Maciekskc/Lock-Arduino-project/zdjęcia do dokumentacji/lock-machanism.jpg

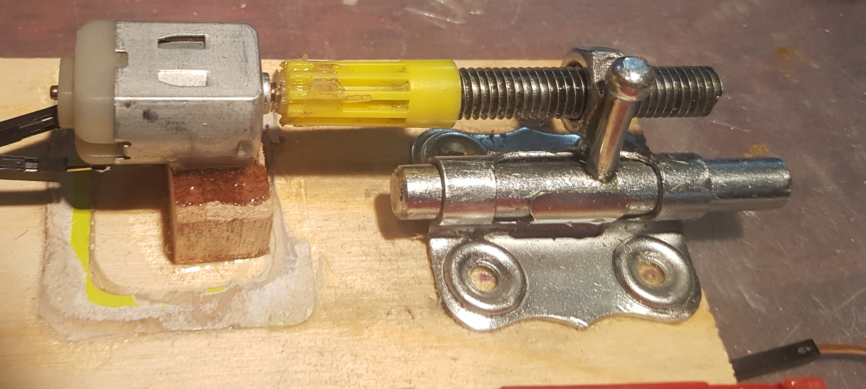
zdjęcia do dokumentacji/lock-machanism.jpg
