Maciekskc/Lock-Arduino-project/zdjęcia do dokumentacji/voltomierz-wyjsciowe.jpg

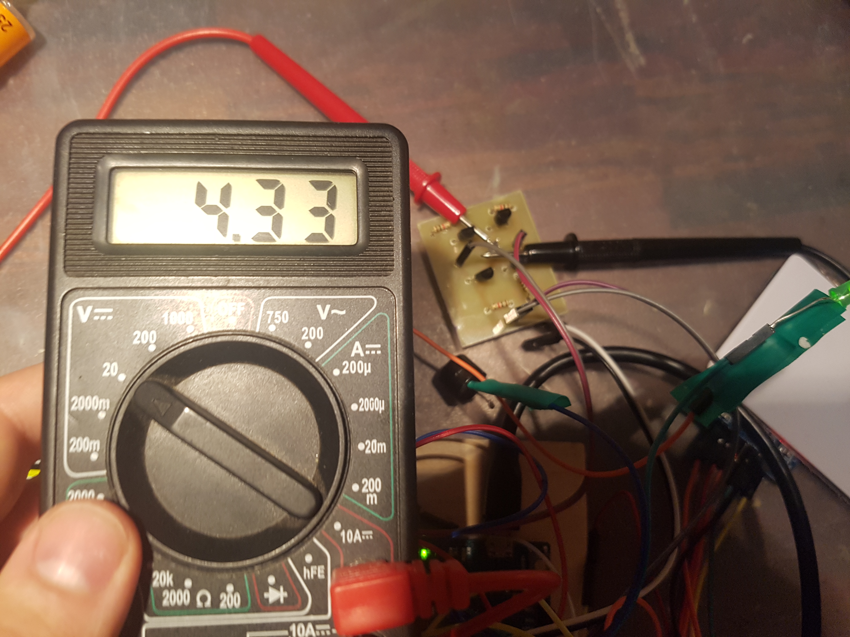
zdjęcia do dokumentacji/voltomierz-wyjsciowe.jpg
