Maciekskc/Lock-Arduino-project/README.md

# Lock-Arduino-project
Projekt elektronicznego zamka do drzwi, realizowany w ramach kursu architektóra komputerów na 4 semestrze studiów
na Poluitechnice Wrocławskiej, wydział elektroniki, kierunek informatyka w roku akademickim 2018/2019.

Zamek jest fizyczną zasówką obsługiwana przez 5-io woltowy silnik elektryczny. Sekwencja zamykania i otwierania
jest organizowana przez płytkę arduino leonardo, przy zczytaniu poprawnej karty magnetycznej przez czujnik RFID.

Cała mechanika działania i szczegółowy opis znajduje się w dokumentacji technicznej urządzenia. Kod projektu znajduje się 
w katalogu 'Projekt-AK2'.
