Maciekskc/Lock-Arduino-project/Sprawozdanie.pdf

### Politechnika Wrocławska

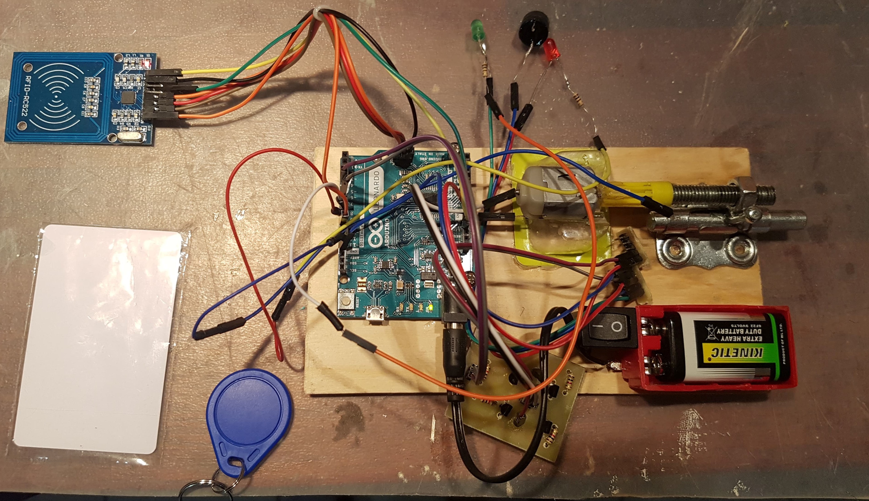
[picture p4: figure]

Architektura Komputerów 2

Projekt

# Sprawozdanie

## Autorzy:

Maciej Białkowski
241285

Dawid Trzebiński
241336

## Prowadzący: dr inż. Dominik Żelazny

Wrocław, 23 maja 2019

# Spis treści

1 Założenia projektu | 1
2 Przebieg projektu | 2
3 Zakończenie projektu | 6

# 1 Założenia projektu

## 1.1 Opis

Celem naszego projektu było skonstruowanie elektronicznego zamka do drzwi wykorzystującego procesor AVR umożliwiającego autoryzacje osób wykorzystując technologię RFID. Zamek miał być w pełni samowystarczalny - posiadać własne zasilanie oraz przechowywać autoryzowane kody. Po wykryciu znanego ID zamek uruchamia sekwencję napisaną w języku assembly, która uruchamia silnik przesuwający/zamykający zasuwkę.

## 1.2 Termin I - 01.04.2019

Zbudowanie modelu fizycznego zamka.
Przygotowanie wszelkich komponentów:
- Arduino Leonardo (z mikrokontrolerem AVR Atmega32U4)
- moduł czytnika kart magnetycznych
- bateria
- gniazdo ładowania
- socket na baterię
- stelaż na silnik
- mechanizm zamka

## 1.3 Termin II - 29.04.2019

Wykorzystanie języka assembly w celu napisania funkcji sterujących silnikiem, brzęczykiem oraz diodami poprzez ustawianie poszczególnych portów jako wyjściowe oraz wprowadzanie ich w stany niskie oraz wysokie.
Wykorzystanie języka C oraz biblioteki MFRC522 obsługującej czujnik kart magnetycznych do napisania ciała programu i wywołań funcji assemblera.

## 1.4 Termin III - 27.05.2019

Wgranie kodu do mikrokontrolera, wpięcie mostka H pozwalającego na organizację kierunku obrotu silnika. Podłączenie zielonej i czerwonej diody oraz brzęczyka do sygnalizacji otwierania i zamykania zamka.
Sporządzenie sprawozdania

# 2 Przebieg projektu

## 2.1 Termin I - 01.04.2019

Udało się zmontować model fizyczny przy użyciu zadeklarowanych komponentów. Podjęcie decyzji o dodaniu mostka H w III etapie projektu.
Etap oddany w założonym terminie.

## 2.2 Termin II - 29.04.2019

Udało się napisać założone funkcje sterujące oraz obsługę czytnika RFID. Etap oddany w załozonym terminie.

FUNKCJE W ASSEMBLY ##########################

#i n cl u d e <avr / i o . h>

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

#u s t a wi e ni e pinow wy jsciowych pi n s S e t u p :

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

r e t

#metody op oznien

del ay 5 0 0m s :
l d i | r18 , 41
l d i | r19 , 150
l d i | r20 , 128
c a l l L1
r e t

L1 : dec r 2 0
brne L1
dec r 1 9
brne L1
dec r 1 8
brne L1
r e t

del ay 1 5 0 0m s :
nop
l d i | r18 , 122
l d i | r19 , 193
l d i | r20 , 130
c a l l L2
r e t

L2 : dec r 2 0
brne L2
dec r 1 9
brne L2
dec r 1 8
brne L2
nop
r e t

#z a t rz ym anie s i l n i k a e n gi n e S t o p :

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

| c bi PORTD−0x20 , 4
| s b i PORTD−0x20 , 7
r e t

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

| s b i PORTB−0x20 , 5
r e t

redLedO f f :
| c bi PORTB−0x20 , 5
r e t

greenLedOn :
s b i PORTB−0x20 , 4
r e t

g reenLedO f f :
c bi PORTB−0x20 , 4
r e t

buzzerOn :
s b i PORTD−0x20 , 6
r e t

b u z z e rO f f :
c bi PORTD−0x20 , 6
r e t

FUNCKJE W JEZYKU C ##########################

#i n cl u d e <SPI . h>

#i n cl u d e <MFRC522. h>

#i n cl u d e ” a s s em bl e r . h”

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

e l s e {
S e r i a l . p r i n t l n ( ” Opening . . . ” ) ;
openin g ( ) ; / / a k c j a o tw o r z e ni a zamka s t a t e = t r u e ;
}
} e l s e {
// niepoprawny a d r e s i d w y swi e tl a komunikat i w o k ni e dialogowym // o nieznanym a d r e s i e i d k a r t y i w y swi e tl a go
S e r i a l . p ri n t ( ” Unknowed c a rd (NR: ” ) ;
S e r i a l . p ri n t ( m frc522 . uid . uidByte [ 0 ] ,HEX) ;
S e r i a l . p ri n t (” −”);
S e r i a l . p ri n t ( m frc522 . uid . uidByte [ 1 ] ,HEX) ; S e r i a l . p ri n t (” −”);
S e r i a l . p ri n t ( m frc522 . uid . uidByte [ 2 ] ,HEX) ; S e r i a l . p ri n t (” −”);
S e r i a l . p ri n t ( m frc522 . uid . uidByte [ 3 ] ,HEX) ; S e r i a l . p r i n t l n ( ” ) , a c c e s s denied ” ) ;
wrongId ( ) ;
}
}
// niepoprawny a d r e s id , b r z e c z y k + czerwona doda v oid wrongId ( ) {
redLedOn ( ) ;
buzzerOn ( ) ;
del ay 1 5 0 0m s ( ) ;
redLedO f f ( ) ;
b u z z e rO f f ( ) ;
}
// o t wi e r a ni e i zamykanie zamka + mi g anie z i e l o n di od a i b r z e c z y k v oid openin g ( ) {
e n gi n e L e f t ( ) ;
greenLedOn ( ) ;
buzzerOn ( ) ;
del ay 5 0 0m s ( ) ;
g reenLedO f f ( ) ;
b u z z e rO f f ( ) ;
del ay 5 0 0m s ( ) ;
greenLedOn ( ) ;
buzzerOn ( ) ;
del ay 5 0 0m s ( ) ;
g reenLedO f f ( ) ;
b u z z e rO f f ( ) ;
e n gi n e S t o p ( ) ;
}
v oid c l o s i n g ( ) {
e n gi n eRi g h t ( ) ;
greenLedOn ( ) ;
buzzerOn ( ) ;
del ay 5 0 0m s ( ) ;
g reenLedO f f ( ) ;
b u z z e rO f f ( ) ;
del ay 5 0 0m s ( ) ;
greenLedOn ( ) ;
buzzerOn ( ) ;
del ay 5 0 0m s ( ) ;
g reenLedO f f ( ) ;
b u z z e rO f f ( ) ;
e n gi n e S t o p ( ) ;
}

## 2.3 Termin III - 27.05.2019

Udało się połączyć elementy zrealizowane w poprzednich etapach projektu oraz wytrawić mo-stek H z płytki PCB i podłączyć go do urządzenia.
Napisano sprawozdanie z projektu.

# 3 Zakończenie projektu

## 3.1 Podsumowanie

Projekt zrealizowano zgodnie z założeniami i oddano w zadeklarowanych terminach. Urządzenie działa zgodnie z oczekiwaniami, jest gotowe do prezentacji.

## 3.2 Napotkane problemy

Powszechnym problemem były niedokładne luty powodujące spadki napięcia oraz luźne elementy konstrukcji. Pomiędzy etapami urządzenie było podatne na uszkodzenia podczas transportu. Przy użyciu niedociętych elementów fizycznych mechanizm zamka działał nieprecyzyjnie i czę-sto blokował się - problem znikł po doszlifowaniu i docięciu elementów.
