Maciekskc/Lock-Arduino-project/zdjęcia do dokumentacji/Arduino - piny.jpg

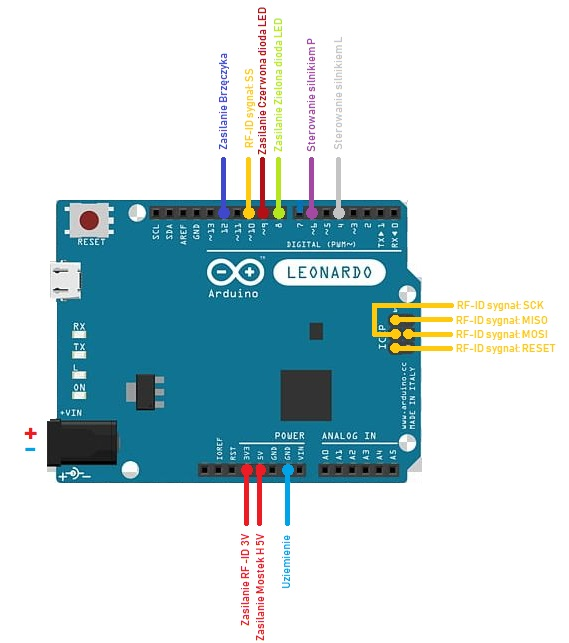
zdjęcia do dokumentacji/Arduino - piny.jpg
