Maciekskc/Lock-Arduino-project/zdjęcia do dokumentacji/charging.png.jpg

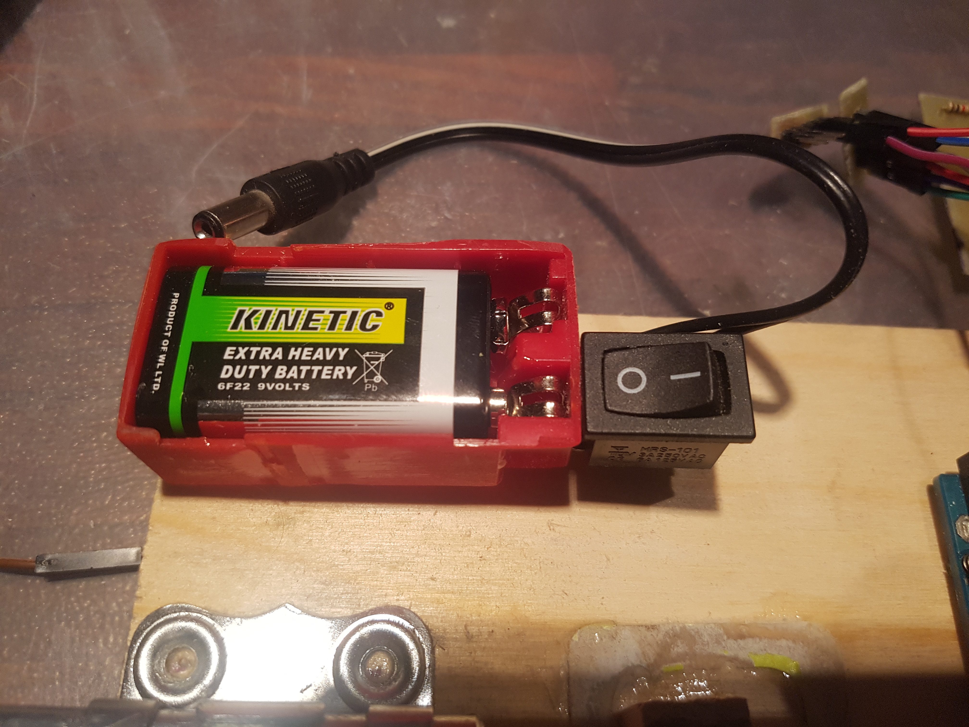
zdjęcia do dokumentacji/charging.png.jpg
