Maciekskc/Lock-Arduino-project/zdjęcia do dokumentacji/diody.jpg

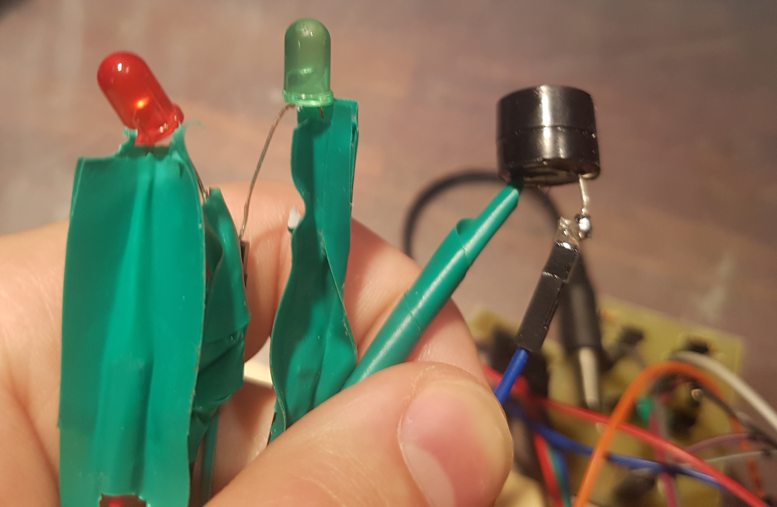
zdjęcia do dokumentacji/diody.jpg
