Maciekskc/Lock-Arduino-project/zdjęcia do dokumentacji/mostek-h-shedule.jpg

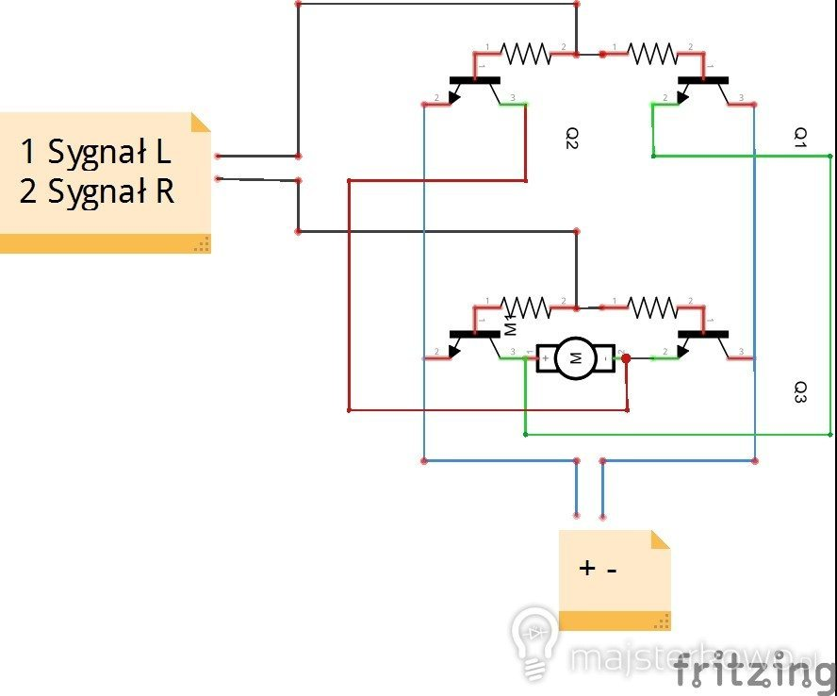
zdjęcia do dokumentacji/mostek-h-shedule.jpg
