Maciekskc/Lock-Arduino-project/zdjęcia do dokumentacji/mostek-h.jpg

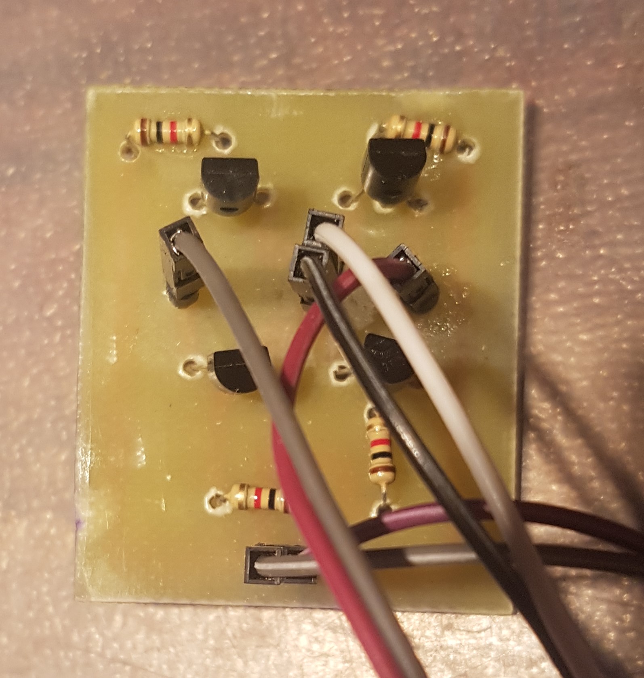
zdjęcia do dokumentacji/mostek-h.jpg
