Maciekskc/Lock-Arduino-project/zdjęcia do dokumentacji/rd-id.jpg

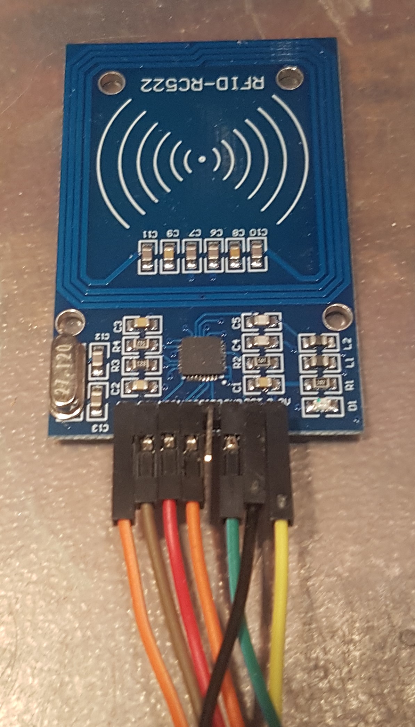
zdjęcia do dokumentacji/rd-id.jpg
