Maciekskc/Lock-Arduino-project/zdjęcia do dokumentacji/voltomierz-wejsciowe.jpg

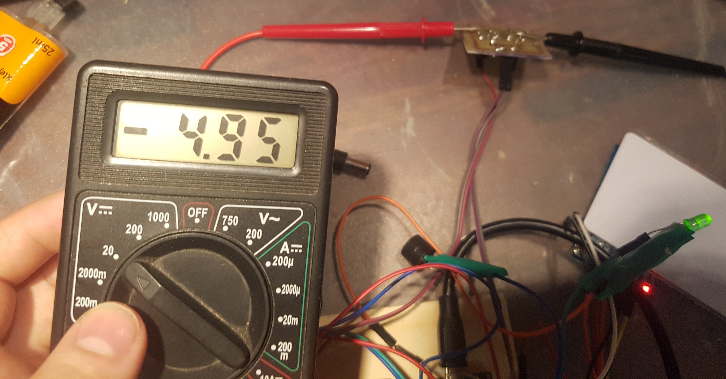
zdjęcia do dokumentacji/voltomierz-wejsciowe.jpg
