Maciekskc/Lock-Arduino-project/Project-AK2/assembler.h

extern "C"
{
	void pinsSetup(void);
	void delay_500ms(void);
	void delay_1500ms(void);
	void engineStop(void);
	void engineLeft(void);
	void engineRight(void);
	void redLedOn(void);
	void redLedOff(void);
	void greenLedOn(void);
	void greenLedOff(void);
	void buzzerOn(void);
	void buzzerOff(void);
}
